gregoryvanko/HydroponX/(list of files, cad)

Other CAD files:
Assets/STL/ModuleSonde.stl
