gregoryvanko/HydroponX/SRC/Module-Capteur/Config.h

#pragma once

// ── PIN -──────────────────────────────────────────────────────────────────────
constexpr uint8_t CONFIG_PIN_DS18B20 = 4;
constexpr uint8_t CONFIG_PIN_WaterPres = 35;
constexpr uint8_t CONFIG_PIN_TRIG = 5;
constexpr uint8_t CONFIG_PIN_ECHO = 18;
constexpr uint8_t CONFIG_PIN_TDS = 34;
constexpr uint8_t CONFIG_PIN_CAN_TX = 17;
constexpr uint8_t CONFIG_PIN_CAN_RX = 16;

// ── Loop ──────────────────────────────────────────────────────────────────────
constexpr uint16_t CONFIG_BAUDRATE = 9600;
constexpr uint32_t CONFIG_MESURE_INTERVAL = 60000;

// ── CAN -──────────────────────────────────────────────────────────────────────
constexpr uint32_t CONFIG_CAN_BAUDRATE        = 500000;
constexpr uint32_t CONFIG_CAN_ID_waterTemp    = 0x101;
constexpr uint32_t CONFIG_CAN_ID_waterEc      = 0x102;
constexpr uint32_t CONFIG_CAN_ID_waterLevel   = 0x103;
constexpr uint32_t CONFIG_CAN_ID_waterPresent = 0x104;
