gregoryvanko/HydroponX/(commit log)

2026-04-26 Enhance README with project details and module functions
    Expanded project description and details about modules and sensor measurements.
2026-05-01 Add image to README for sensor description
2026-05-01 Update README with MQTT gateway module details
    Added architecture and wiring details for the MQTT gateway module.
2026-05-01 Revise wiring table for pump relay connections
    Updated the wiring table for the pump relay in the README.
2026-05-01 Update sensor descriptions and data transmission info
    Clarified sensor measurement descriptions and added data transmission details.
2026-05-14 Fix sensor descriptions and GPIO pin mappings
    Updated sensor descriptions and GPIO pin assignments in README.
2026-05-17 Add ESP32 pinout section with image
2026-05-17 Add configuration constants for sensor module
2026-05-25 Insert architecture image in README
    Added architecture image for Module gateway MQTT.
2026-05-25 Include STL image for Module Sonde in README
    Add STL file image reference for Module Sonde.
2026-05-25 Remove STL image from README
    Removed STL file image from README.
2026-06-18 Initialize CAN filter for water temperature and presence
    Add CAN filter initialization for water temperature and presence.
2026-06-18 Improve setFilterRange logic in CANManager
    Refactor filter range calculation for CAN messages.
2026-06-18 Modify relay pin assignments and MQTT topics
    Updated relay and MQTT topics information in README.
2026-07-09 Add default Node-RED settings file
    This is the default settings file for Node-RED, containing configuration options for flow files, security, server settings, runtime settings, editor settings, and node settings.
